nthdimtech/signet-hc-pcb/signet2-production-bom.ods

Item # | Qty | Ref Des | Description | Specs | Manufacturer | Mfg Part # | Package | Connections | Total connections | Type | DNP
1 | 1 | IC1 | EMMC Flash Memory | 256Gbit | Toshiba | THGBMHG8C2LBAIL | WFBGA153 | 153 | 153 | SMT
2 | 1 | U1 | 3.3v Linear Regulator |  | ST | LDFM33PUR | VDFN6 | 6 | 6 | SMT
3 | 1 | U2 | Cortex M7 microcontroller |  | ST | STM32F733IEK6 | UFBGA-176 | 201 | 201 | SMT
4 | 3 | C11, C12, C16 | Ceramic capacitor | 4.7uF, 6.3V, X5R | Murata | GRM155R60J475ME47D | 402 | 2 | 6 | SMT
5 | 3 | C2, C21, C25 | Ceramic capacitor | 2.2uF, 6.3V, X5R | Murata | GRM155R60J225KE95D | 402 | 2 | 6 | SMT
6 | 1 | C1 | Ceramic capacitor | 1uF, 10V, X5R | Yageo | CC0402KRX5R6BB105 | 402 | 2 | 2 | SMT
7 | 17 | C3-C10, C13-C15, C17-C20,C26-C27 | Ceramic capacitor | 100nF, 6.3V, X5R | Yageo | CC0201KRX5R5BB104 | 201 | 2 | 34 | SMT
8 | 13 | R1,R3, R5-R12,R14,R15,R17 | Resistor | 10k Ohms, 1/20W, 5% | Yageo | RC0201JR-0710KL | 201 | 2 | 26 | SMT
9 | 2 | R2, R13 | Resistor | 100 Ohms, 1/16W, 5% | Panasonic | ERA-2AED101X | 402 | 2 | 4 | SMT
10 | 2 | D1, D2 | LED | 2.9 Vf, 5mA | Vishay | VLMB1500-GS08 | 402 | 2 | 4 | SMT
11 | 1 | J1 | USB plug |  | Molex | 480372200 |  | 4 | 4 | TH | Yes
12 | 1 | SW1 | Tactile switch | 100gf | Panasonic | EVQ-PLDA15 |  | 4 | 4 | SMT
13 | 2 | C22, C23 | Ceramic capacitor | 16pF, low ESR | AVX | 04025U160FAT2A | 402 | 2 | 4 | SMT
14 | 1 | Y1 | Crystal oscillator | 12Mhz, 8pF | Abracon | ABM10-167-12.000MHZ-T3 | 4SMD – 2.5mm x 2mm | 4 | 4 | SMT
15 | 1 | C29 | Ceramic capacitor | 10nF, 25V, X5R | Murata | GRM033R61E103KA12D | 201 | 2 | 2 | SMT
16 | 1 | U3 | TVS Diode |  | ST | USBULC6-2M6 | 6UQFN | 6 | 6 | SMT
17 | 1 | R4 | Resistor | 3k Ohms, 1% | Panasonic | ERJ-1GNF3001C | 201 | 2 | 2 | SMT
18 | 1 | R18 | Resistor | 100k, 1/20W, 1% | Yageo | RC0201FR-07100KL | 201 | 2 | 2 | SMT
Total | 53 |  |  |  |  |  |  |  | 470
