nthdimtech/signet-hc-pcb/signet2.kicad_pcb

## KiCad design signet2.kicad_pcb (2019-09-22)

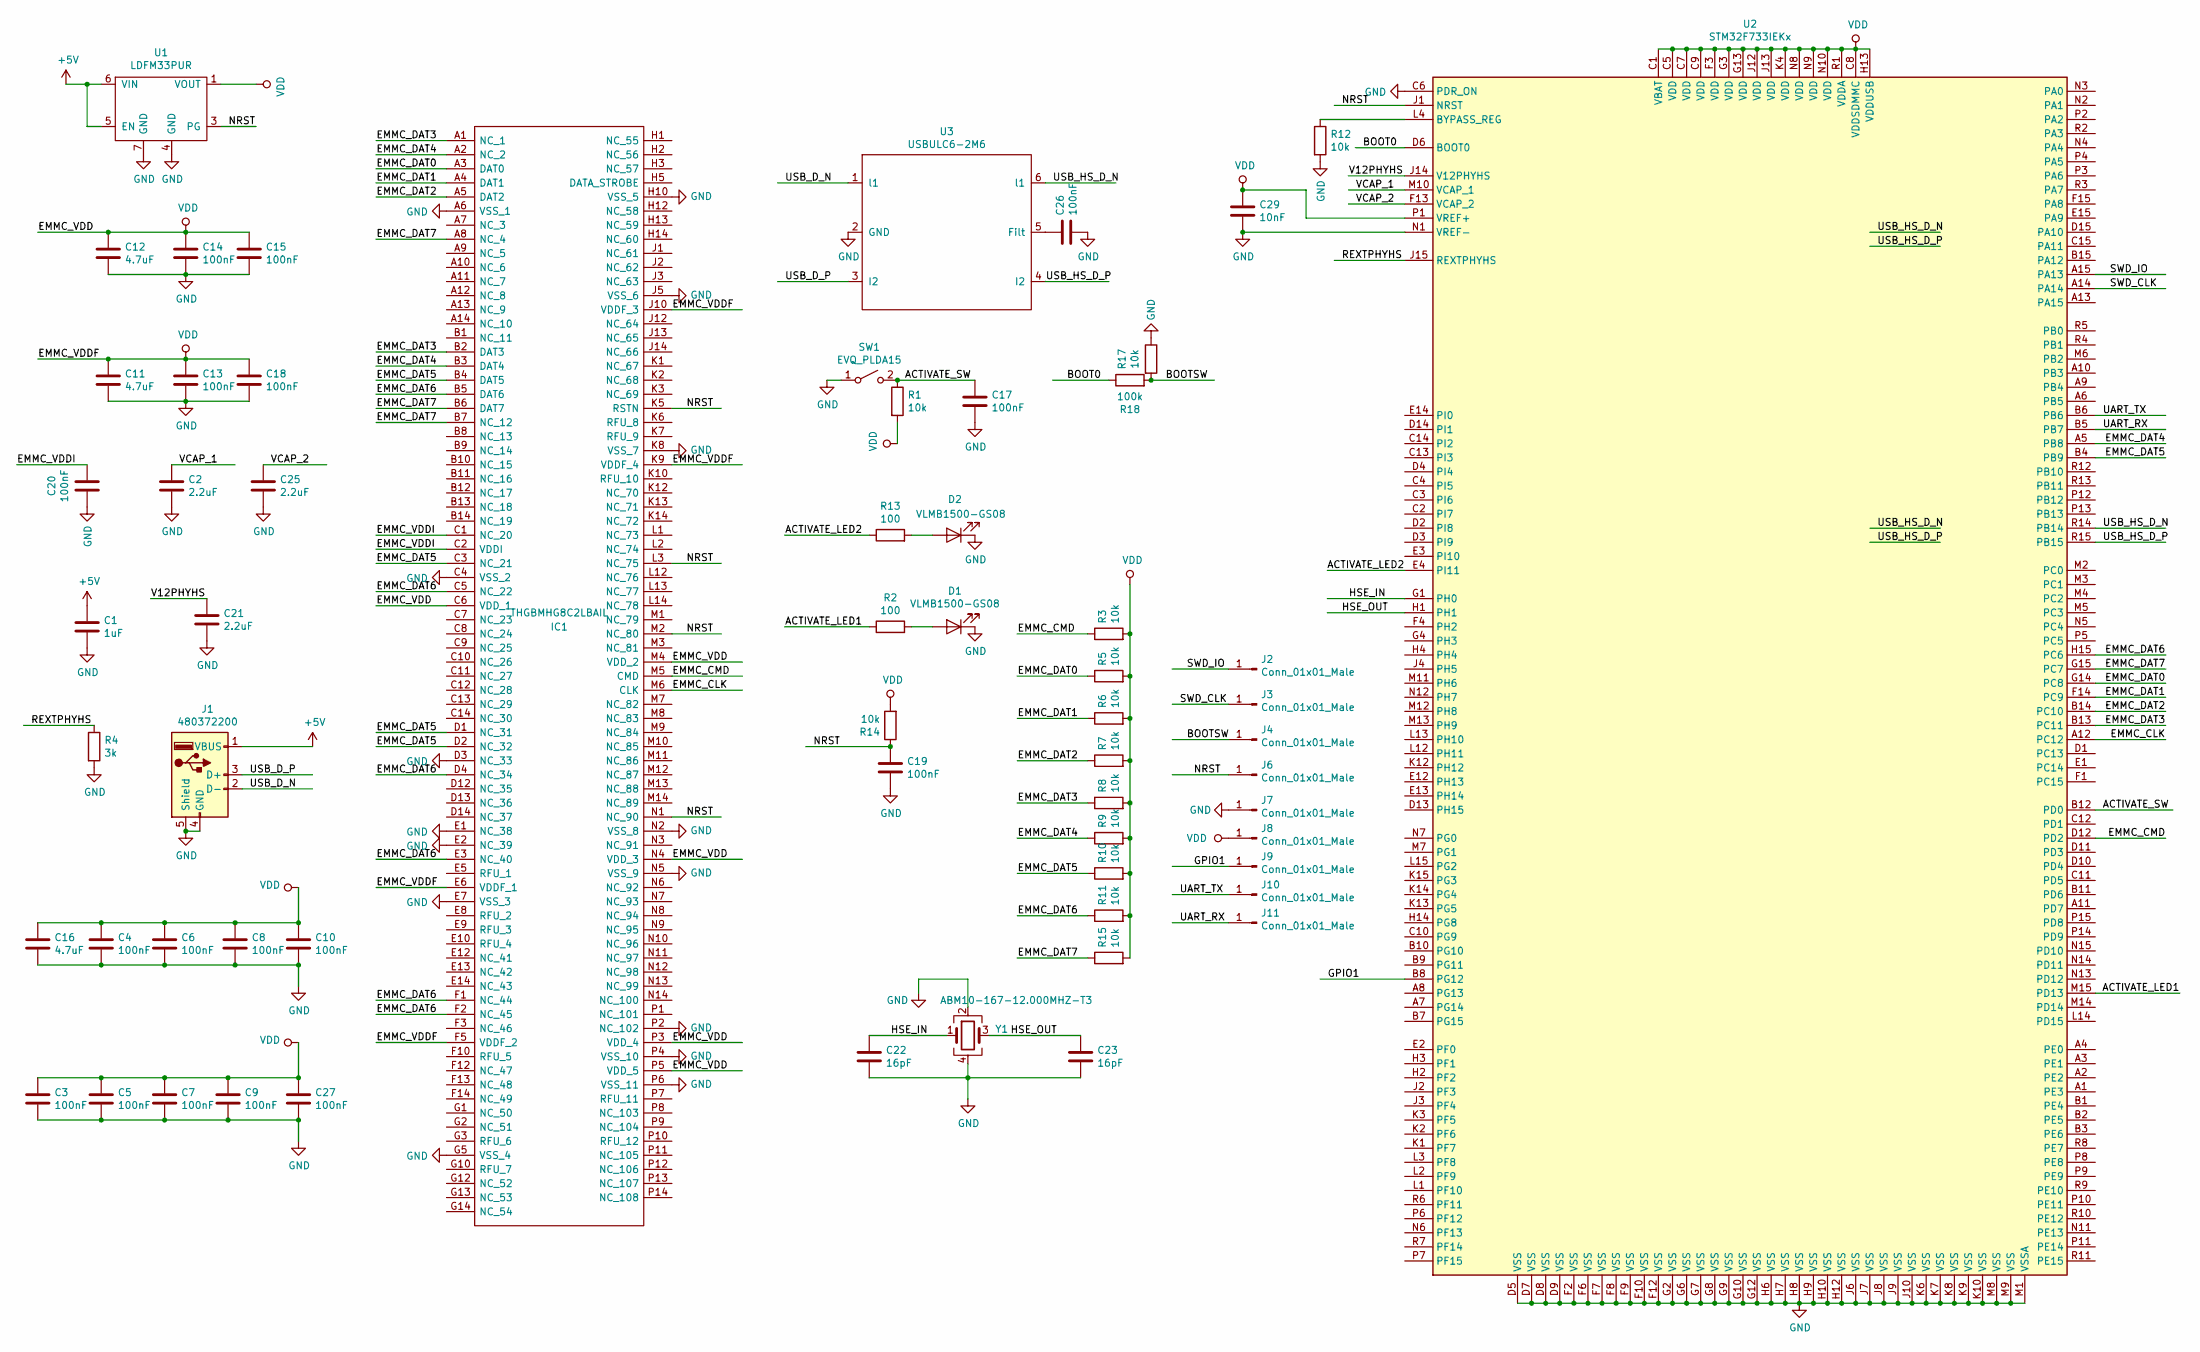
[picture p1: schematic signet2.sch]

Parts:
C1: 1uF; C_0402_1005Metric
C2, C21, C25: 2.2uF; C_0402_1005Metric
C3, C4, C5, C6, C7, C8, C9, C10, C13, C14, C15, C17, C18, C19, C20, C26, C27: 100nF; C_0201_0603Metric
C11, C12, C16: 4.7uF; C_0402_1005Metric
C22, C23: 16pF; C_0402_1005Metric
C29: 10nF; R_0201_0603Metric
D1, D2: VLMB1500-GS08; D_0402_1005Metric
IC1: THGBMHG8C2LBAIL; FBGA153
J1: 480372200; MOLEX-480037-2200
J2, J3, J4, J6, J7, J8, J9, J10, J11: Conn_01x01_Male; TestPoint_Pad_1.5x1.5mm
R1, R3, R5, R6, R7, R8, R9, R10, R11, R12, R14, R15, R17: 10k; R_0201_0603Metric
R2, R13: 100; R_0402_1005Metric
R4: 3k; R_0201_0603Metric
R18: 100k; R_0201_0603Metric
SW1: EVQ_PLDA15; SW_SPST_Panasonic_EVQPL_3PL_5PL_PT_A15
U1: LDFM33PUR; VDFN6
U2: STM32F733IEKx; UFBGA-201_10x10mm_Layout15x15_P0.65mm
U3: USBULC6-2M6; ST_UQFN-6L_1.5x1.7mm_Pitch0.5mm
Y1: ABM10-167-12.000MHZ-T3; Crystal_SMD_2520-4Pin_2.5x2.0mm

Connections:
+5V: C1.1, J1.1 (VBUS), U1.5 (EN), U1.6 (VIN)
/ACTIVATE_LED1: R2.1, U2.M15 (PD13)
/ACTIVATE_LED2: R13.1, U2.E4 (PI11)
/ACTIVATE_SW: C17.1, R1.1, SW1.2 (B), U2.B12 (PD0)
/BOOT0: R18.1, U2.D6 (BOOT0)
/BOOTSW: J4.1, R17.2, R18.2
/EMMC_CLK: IC1.M6 (CLK), U2.A12 (PC12)
/EMMC_CMD: IC1.M5 (CMD), R3.1, U2.D12 (PD2)
/EMMC_DAT0: IC1.A3 (DAT0), R5.1, U2.G14 (PC8)
/EMMC_DAT1: IC1.A4 (DAT1), R6.1, U2.F14 (PC9)
/EMMC_DAT2: IC1.A5 (DAT2), R7.1, U2.B14 (PC10)
/EMMC_DAT3: IC1.A1 (NC_1), IC1.B2 (DAT3), R8.1, U2.B13 (PC11)
/EMMC_DAT4: IC1.A2 (NC_2), IC1.B3 (DAT4), R9.1, U2.A5 (PB8)
/EMMC_DAT5: IC1.B4 (DAT5), IC1.C3 (NC_21), IC1.D1 (NC_31), IC1.D2 (NC_32), R10.1, U2.B4 (PB9)
/EMMC_DAT6: IC1.B5 (DAT6), IC1.C5 (NC_22), IC1.D4 (NC_34), IC1.E3 (NC_40), IC1.F1 (NC_44), IC1.F2 (NC_45), R11.1, U2.H15 (PC6)
/EMMC_DAT7: IC1.A8 (NC_4), IC1.B6 (DAT7), IC1.B7 (NC_12), R15.1, U2.G15 (PC7)
/EMMC_VDDI: C20.1, IC1.C1 (NC_20), IC1.C2 (VDDI)
/GPIO1: J9.1, U2.B8 (PG12)
/HSE_IN: C22.1, U2.G1 (PH0), Y1.1
/HSE_OUT: C23.1, U2.H1, Y1.3
/NRST: C19.1, IC1.K5 (RSTN), IC1.L3 (NC_75), IC1.M2 (NC_80), IC1.N1 (NC_90), J6.1, R14.1, U1.3 (PG), U2.J1 (NRST)
/REXTPHYHS: R4.1, U2.J15 (REXTPHYHS)
/SWD_CLK: J3.1, U2.A14
/SWD_IO: J2.1, U2.A15 (PA13)
/UART_RX: J11.1, U2.B5 (PB7)
/UART_TX: J10.1, U2.B6
/USB_D_N: J1.2 (D-), U3.1 (l1)
/USB_D_P: J1.3 (D+), U3.3 (I2)
/USB_HS_D_N: U2.R14 (PB14), U3.6 (l1)
/USB_HS_D_P: U2.R15 (PB15), U3.4 (I2)
/V12PHYHS: C21.1, U2.J14 (V12PHYHS)
/VCAP_1: C2.1, U2.M10 (VCAP_1)
/VCAP_2: C25.1, U2.F13 (VCAP_2)
GND: C1.2, C2.2, C3.2, C4.2, C5.2, C6.2, C7.2, C8.2, C9.2, C10.2, C11.2, C12.2, C13.2, C14.2, C15.2, C16.2, C17.2, C18.2, C19.2, C20.2, C21.2, C22.2, C23.2, C25.2, C26.2, C27.2, C29.2, D1.1 (K), D2.1 (K), IC1.A6 (VSS_1), IC1.C4 (VSS_2), IC1.D3 (NC_33), IC1.E1 (NC_38), IC1.E2 (NC_39), IC1.E7 (VSS_3), IC1.G5 (VSS_4), IC1.H10 (VSS_5), IC1.J5 (VSS_6), IC1.K8 (VSS_7), IC1.N2 (VSS_8), IC1.N5 (VSS_9), IC1.P2 (NC_102), IC1.P4 (VSS_10), IC1.P6 (VSS_11), J1.4 (GND), J1.5 (Shield), J7.1, R4.2, R12.2, R17.1, SW1.1 (A), U1.4 (GND), U1.7 (GND), U2.C6 (PDR_ON), U2.D5 (VSS), U2.D7 (VSS), U2.D8 (VSS), U2.D9 (VSS), U2.F2 (VSS), U2.F6 (VSS), U2.F7 (VSS), U2.F8 (VSS), U2.F9 (VSS), U2.F10 (VSS), U2.F12 (VSS), U2.G2 (VSS), U2.G6 (VSS), U2.G7 (VSS), U2.G8 (VSS), U2.G9 (VSS), U2.G10 (VSS), U2.G12 (VSS), U2.H6 (VSS), U2.H7 (VSS), U2.H8 (VSS), U2.H9 (VSS), U2.H10 (VSS), U2.H12 (VSS), U2.J6 (VSS), U2.J7 (VSS), U2.J8 (VSS), U2.J9 (VSS), U2.J10 (VSS), U2.K6 (VSS), U2.K7 (VSS), U2.K8 (VSS), U2.K9 (VSS), U2.K10 (VSS), U2.M1 (VSSA), U2.M8 (VSS), U2.M9 (VSS), U2.N1 (VREF-), U3.2 (GND), Y1.2, Y1.4
unnamed: C26.1, U3.5 (Filt)
unnamed: D1.2 (A), R2.2
unnamed: D2.2 (A), R13.2
unnamed: R12.1, U2.L4 (BYPASS_REG)
VDD: C3.1, C4.1, C5.1, C6.1, C7.1, C8.1, C9.1, C10.1, C11.1, C12.1, C13.1, C14.1, C15.1, C16.1, C18.1, C27.1, C29.1, IC1.C6 (VDD_1), IC1.E6 (VDDF_1), IC1.F5 (VDDF_2), IC1.J10 (VDDF_3), IC1.K9 (VDDF_4), IC1.M4 (VDD_2), IC1.N4 (VDD_3), IC1.P3 (VDD_4), IC1.P5 (VDD_5), J8.1, R1.2, R3.2, R5.2, R6.2, R7.2, R8.2, R9.2, R10.2, R11.2, R14.2, R15.2, U1.1 (VOUT), U2.C1 (VBAT), U2.C5 (VDD), U2.C7 (VDD), U2.C8 (VDDSDMMC), U2.C9 (VDD), U2.F3 (VDD), U2.G3 (VDD), U2.G13 (VDD), U2.H13 (VDDUSB), U2.J12 (VDD), U2.J13 (VDD), U2.K4 (VDD), U2.N8 (VDD), U2.N9 (VDD), U2.N10 (VDD), U2.P1 (VREF+), U2.R1 (VDDA)

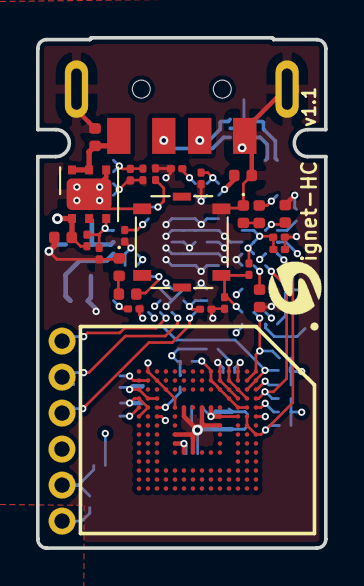
[picture p2: board signet2.kicad_pcb from above]

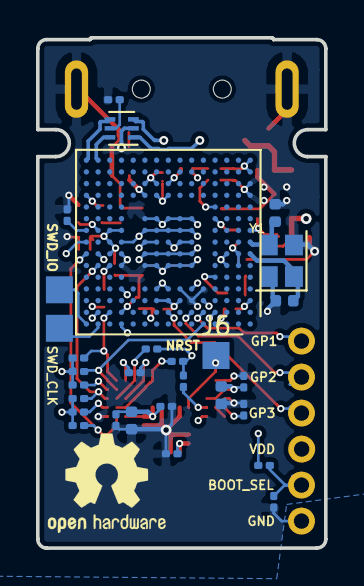
[picture p3: board signet2.kicad_pcb from below]

Board: 6 copper layers, 16.0 x 28.3 mm, 62 parts (35 on the bottom side), 39 nets.
