nthdimtech/signet-hc-pcb/(commit log)

2019-09-13 Thermal and mechanical improvements
    - Change user header to round through hole pads
    - Remove most GND pour areas around user header GND pin so it is easier
    to heat and solder/desolder
    - Tighten fit of USB connector mounting slots
    - Reduce the size of the increased thickness area at USB connector
    [signet2.kicad_pcb, signet2.sch]
2019-09-22 Version 1.22
    - Add GND plane pour to GND line through-hole connection
    - Change visual layout in schematic (connections are the same)
    - Make area sticking out near USB port smaller. Needed to take into
    consideration the possible need for the port to be able to bend
    slightly down to fit in enclosure. This will depend on the exact PCB
    thickness and how the USB port seats on it.
    [signet2.kicad_pcb, signet2.sch]
